Bourrasque-21/RV32I_mcu/rv32i_diagram.png

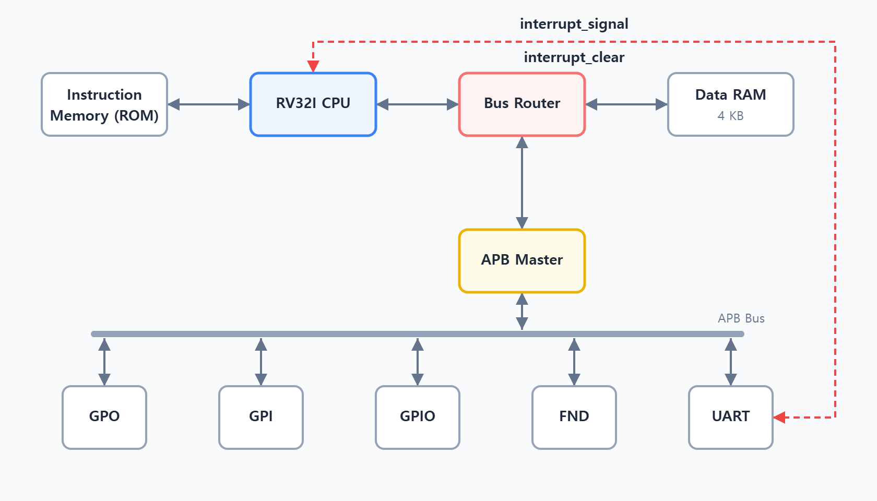
rv32i_diagram.png
