Bourrasque-21/RV32I_mcu/single_cycle/sources_1/core/instruction_mem.sv

`timescale 1ns / 1ps

module instruction_mem (
    input  [31:0] instr_addr,
    output [31:0] instr_data
);

    logic [31:0] rom[0:127];

 initial begin
    $readmemh("C:/Users/sciab/Desktop/AS/RISC-V/RV32I_02/RV32I_02.srcs/sources_1/core/_rv32i_rom_data.mem", rom);
end

    assign instr_data = rom[instr_addr[31:2]];

endmodule
