Bourrasque-21/RV32I_mcu/multi_cycle/sources_1/imports/new/instruction_mem.sv

`timescale 1ns / 1ps

module instruction_mem (
    input  [31:0] instr_addr,
    output [31:0] instr_data
);

    logic [31:0] rom[0:63];

    initial begin
        // for (int i = 0; i < 32; i++) begin
        //     rom[i] = 32'h00000013;
        // end

        $readmemh("_riscv_rv32i_rom_data.mem", rom);

    end

    assign instr_data = rom[instr_addr[31:2]];

endmodule
