Bourrasque-21/RV32I_mcu/multi_cycle/sources_1/new/gpio_03.sv

`timescale 1ns / 1ps

module APB_GPIO (
    input               PCLK,
    input               PRESET,
    input        [31:0] PADDR,
    input        [31:0] PWDATA,   // 16 LED
    input               PENABLE,
    input               PWRITE,
    input               PSEL,
    output logic [31:0] PRDATA,
    output logic        PREADY,
    inout  logic [15:0] GPIO
);

    localparam [11:0] GPIO_CTL_ADDR = 12'h000;
    localparam [11:0] GPIO_ODATA_ADDR = 12'h004;
    localparam [11:0] GPIO_IDATA_ADDR = 12'h008;

    logic [15:0] GPIO_ODATA_REG, GPIO_CTL_REG, GPIO_IDATA_REG;
    // logic [15:0] w_gpi;

    assign PREADY = (PENABLE & PSEL) ? 1'b1 : 1'b0;

    assign PRDATA = (PADDR[11:0] == GPIO_CTL_ADDR)? {16'h0000,GPIO_CTL_REG}: 
                    (PADDR[11:0] == GPIO_ODATA_ADDR) ? {16'h0000,GPIO_ODATA_REG} : 
                    (PADDR [11:0] == GPIO_IDATA_ADDR) ? {16'h0000,GPIO_IDATA_REG} : 32'hxxxx_xxxx;

    always_ff @(posedge PCLK, posedge PRESET) begin
        // GPIO_IDATA_REG <= GPIO;
        if (PRESET) begin
            GPIO_ODATA_REG <= 16'h0000;
            GPIO_CTL_REG   <= 16'h0000;
            // GPIO_IDATA_REG <= 16'h0000;
        end else begin
            if (PREADY) begin
                if (PWRITE) begin
                    case (PADDR[11:0])
                        GPIO_CTL_ADDR:   GPIO_CTL_REG <= PWDATA[15:0];
                        GPIO_ODATA_ADDR: GPIO_ODATA_REG <= PWDATA[15:0];
                    endcase

                end
            end

        end
    end

    gpio U_GPIO (
        .ctl(GPIO_CTL_REG),
        .o_data(GPIO_ODATA_REG),
        .i_data(GPIO_IDATA_REG),
        .gpio(GPIO)
    );

endmodule


module gpio (
    input        [15:0] ctl,
    input        [15:0] o_data,
    output logic [15:0] i_data,
    inout  logic [15:0] gpio
);

    genvar i;
    generate
        for (i = 0; i < 16; i++) begin
            assign gpio[i]   = ctl[i] ? o_data[i] : 1'bz;  // 출력
            assign i_data[i] = ~ctl[i] ? gpio[i] : 1'b0;

        end
    endgenerate


endmodule
