Bourrasque-21/RV32I_mcu/multi_cycle/sources_1/new/gpo_01.sv

`timescale 1ns / 1ps

module APB_GPO (
    input               PCLK,
    input               PRESET,
    input        [31:0] PADDR,
    input        [31:0] PWDATA,
    input               PENABLE,
    input               PWRITE,
    input               PSEL,
    output logic [31:0] PRDATA,
    output logic        PREADY,
    output logic [ 7:0] GPO_OUT
);

    localparam [11:0] GPO_CTL_ADDR   = 12'h000;
    localparam [11:0] GPO_ODATA_ADDR = 12'h004;

    logic [7:0] GPO_ODATA_REG, GPO_CTL_REG;

    assign PREADY = PENABLE & PSEL;

    assign PRDATA = (PADDR[11:0] == GPO_CTL_ADDR)   ? {24'h000000, GPO_CTL_REG} :
                    (PADDR[11:0] == GPO_ODATA_ADDR) ? {24'h000000, GPO_ODATA_REG} :
                                                      32'h0000_0000;

    always_ff @(posedge PCLK, posedge PRESET) begin
        if (PRESET) begin
            GPO_ODATA_REG <= 8'h00;
            GPO_CTL_REG   <= 8'h00;
        end else begin
            if (PREADY & PWRITE) begin
                case (PADDR[11:0])
                    GPO_CTL_ADDR:   GPO_CTL_REG <= PWDATA[7:0];
                    GPO_ODATA_ADDR: GPO_ODATA_REG <= PWDATA[7:0];
                endcase
            end
        end
    end

    genvar i;
    generate
        for (i = 0; i < 8; i++) begin
            assign GPO_OUT[i] = GPO_CTL_REG[i] ? GPO_ODATA_REG[i] : 1'b0;
        end
    endgenerate

endmodule
